4easy/M-Board/README.md

M-Board
=======
 _______       ______                       _
