4easy/M-Board/hardware/MCU.pdf

XTAL1 17

UGnd 5
GND 15
GND 23
GND 43 GND 35
