4easy/M-Board/hardware/Power.pdf

Vin 5

SHDN 4
