4easy/M-Board/arduino libraries/MBoard/examples/Button/Button.ino

/*
 M-Board Button
 
 Turns on and off a light emitting diode(LED) connected to digital  
 pin 13, when pressing a pushbutton attached to pin 7. 
 
 
 The circuit:
 * LED attached from pin 13 to ground 
 * pushbutton attached to pin 7 from +5V
 * 10K resistor attached to pin 7 from ground
 
 * Note: on most Arduinos there is already an LED on the board
 attached to pin 13.
 
 Library originally added 12 August 2014
 by Blue
 
 This example code is in the public domain.
 
 http://easy.cc
 */

// constants won't change. They're used here to 
// set pin numbers:
const int buttonPin = 7;     // the number of the pushbutton pin
const int ledPin =  13;      // the number of the LED pin

// variables will change:
int buttonState = 0;         // variable for reading the pushbutton status

void setup() {
  // initialize the LED pin as an output:
  pinMode(ledPin, OUTPUT);      
  // initialize the pushbutton pin as an input:
  pinMode(buttonPin, INPUT);     
}

void loop(){
  // read the state of the pushbutton value:
  buttonState = digitalRead(buttonPin);

  // check if the pushbutton is pressed.
  // if it is, the buttonState is HIGH:
  if (buttonState == HIGH) {     
    // turn LED on:    
    digitalWrite(ledPin, HIGH);  
  } 
  else {
    // turn LED off:
    digitalWrite(ledPin, LOW); 
  }
}
